terenceang/zx-sizif-512/images/revA.webp

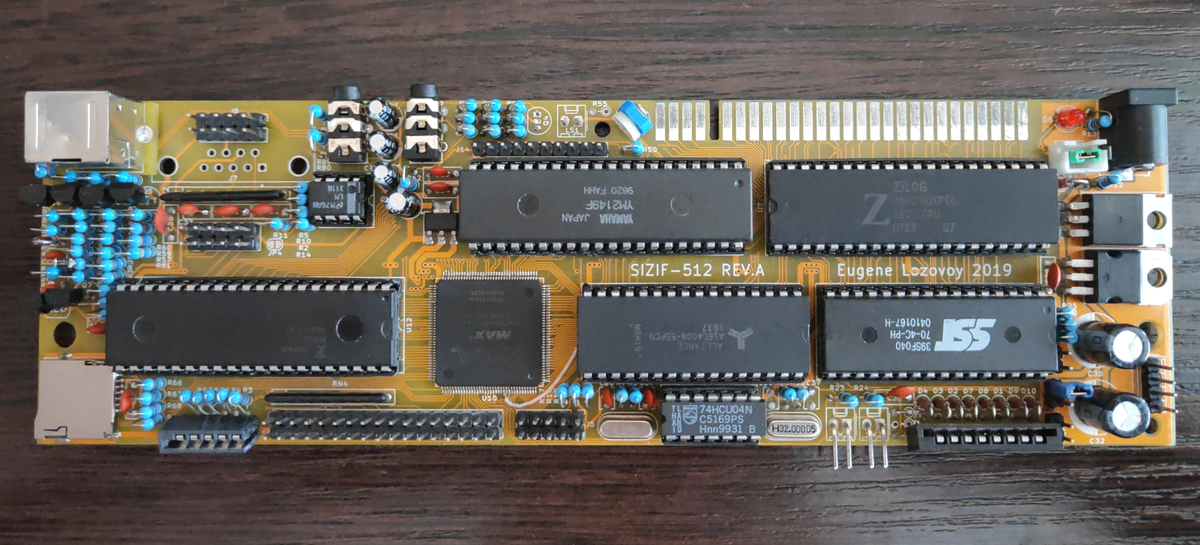
images/revA.webp
