terenceang/zx-sizif-512/images/revE.small.webp

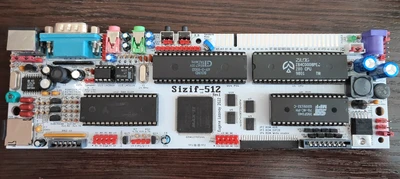
images/revE.small.webp
