terenceang/zx-sizif-512/out/pcb.rev.D1.pdf

# IO1_18/GCLK0 18 VCCINT 19

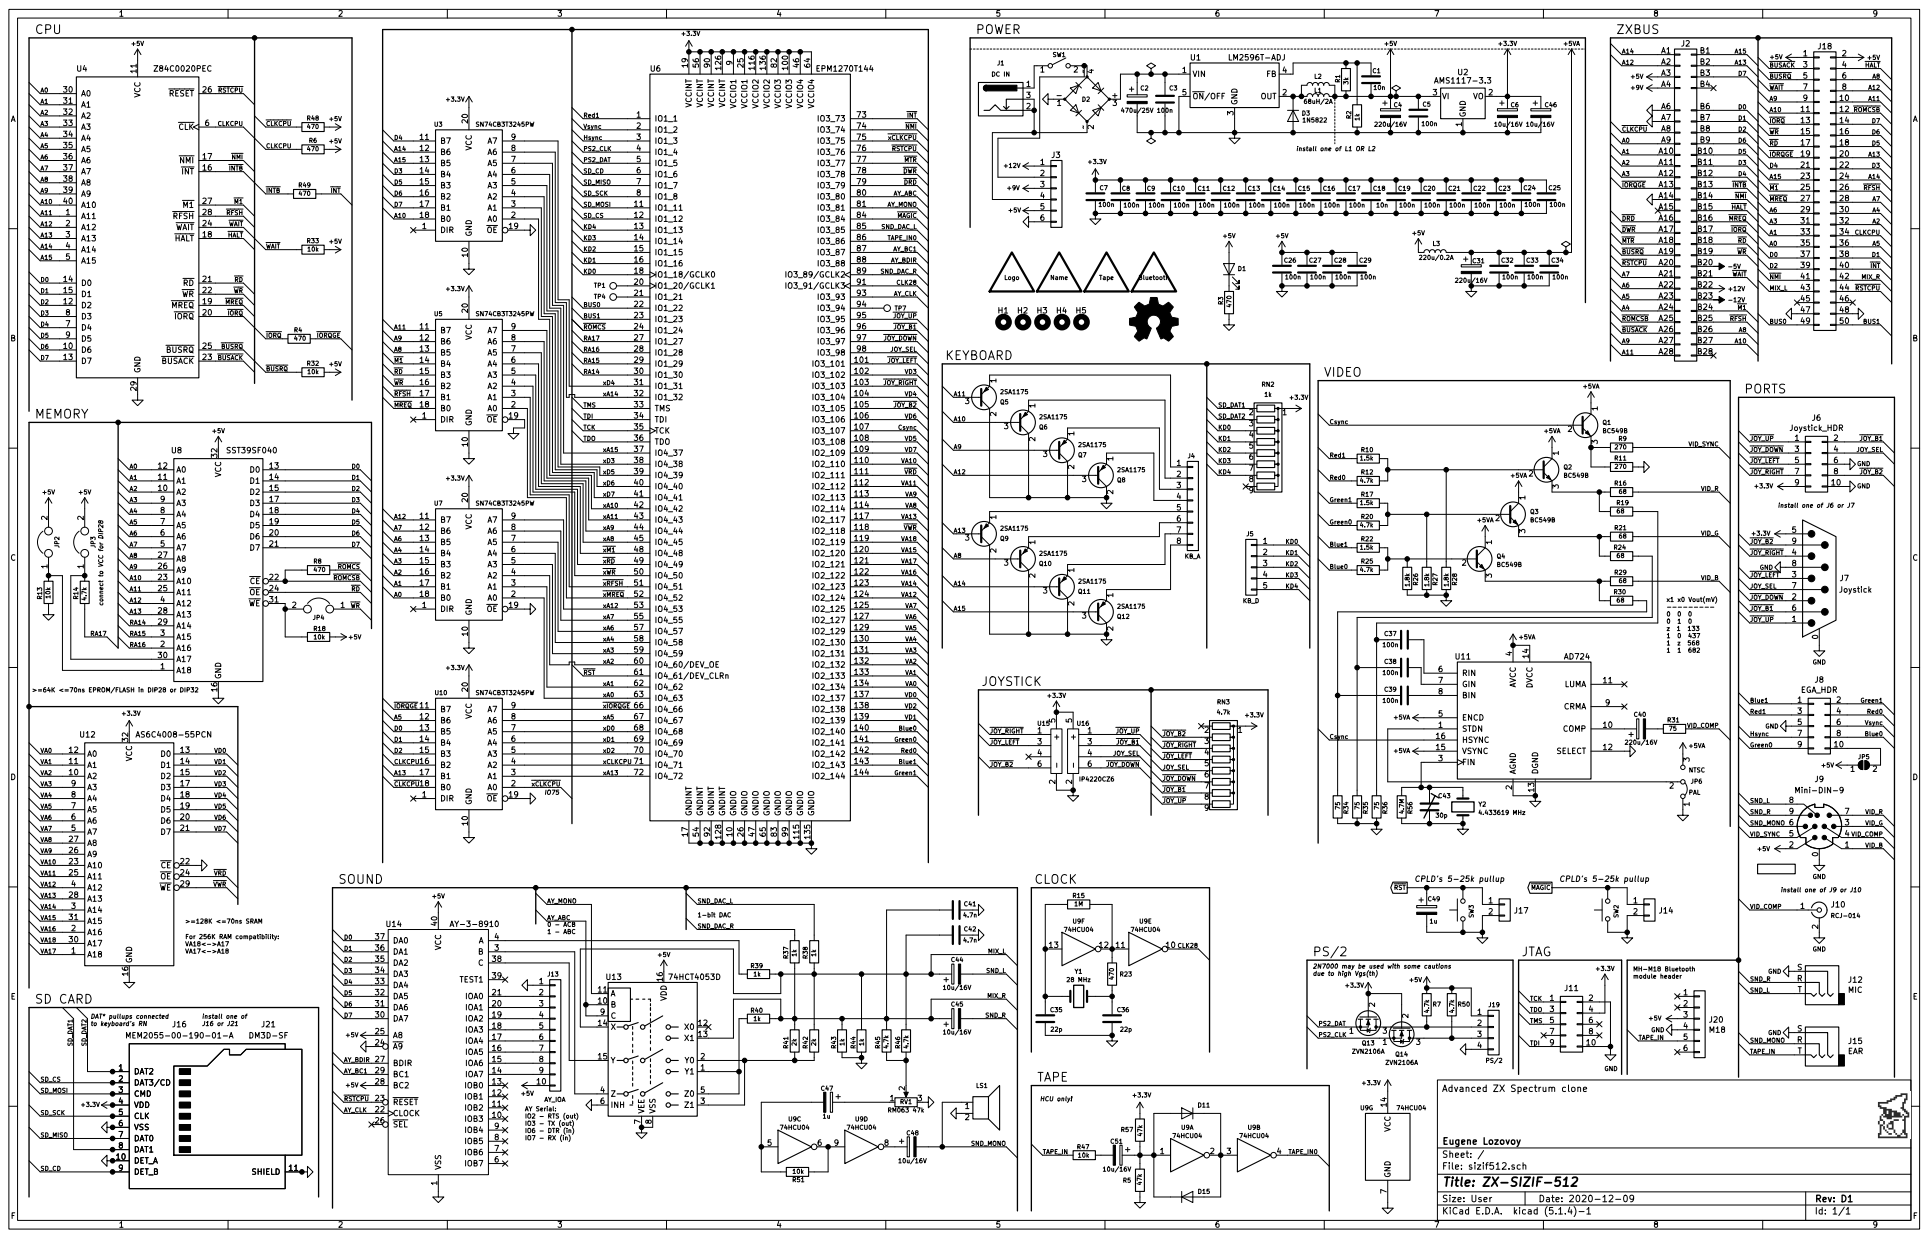
[picture p10: page 1]

install one of L1 OR L2

install one of J6 or J7

connect to VCC for DIP28

>=64K <=70ns EPROM/FLASH in DIP28 or DIP32

install one of J9 or J10

2N7000 may be used with some cautions
due to high Vgs(th)

Advanced ZX Spectrum clone

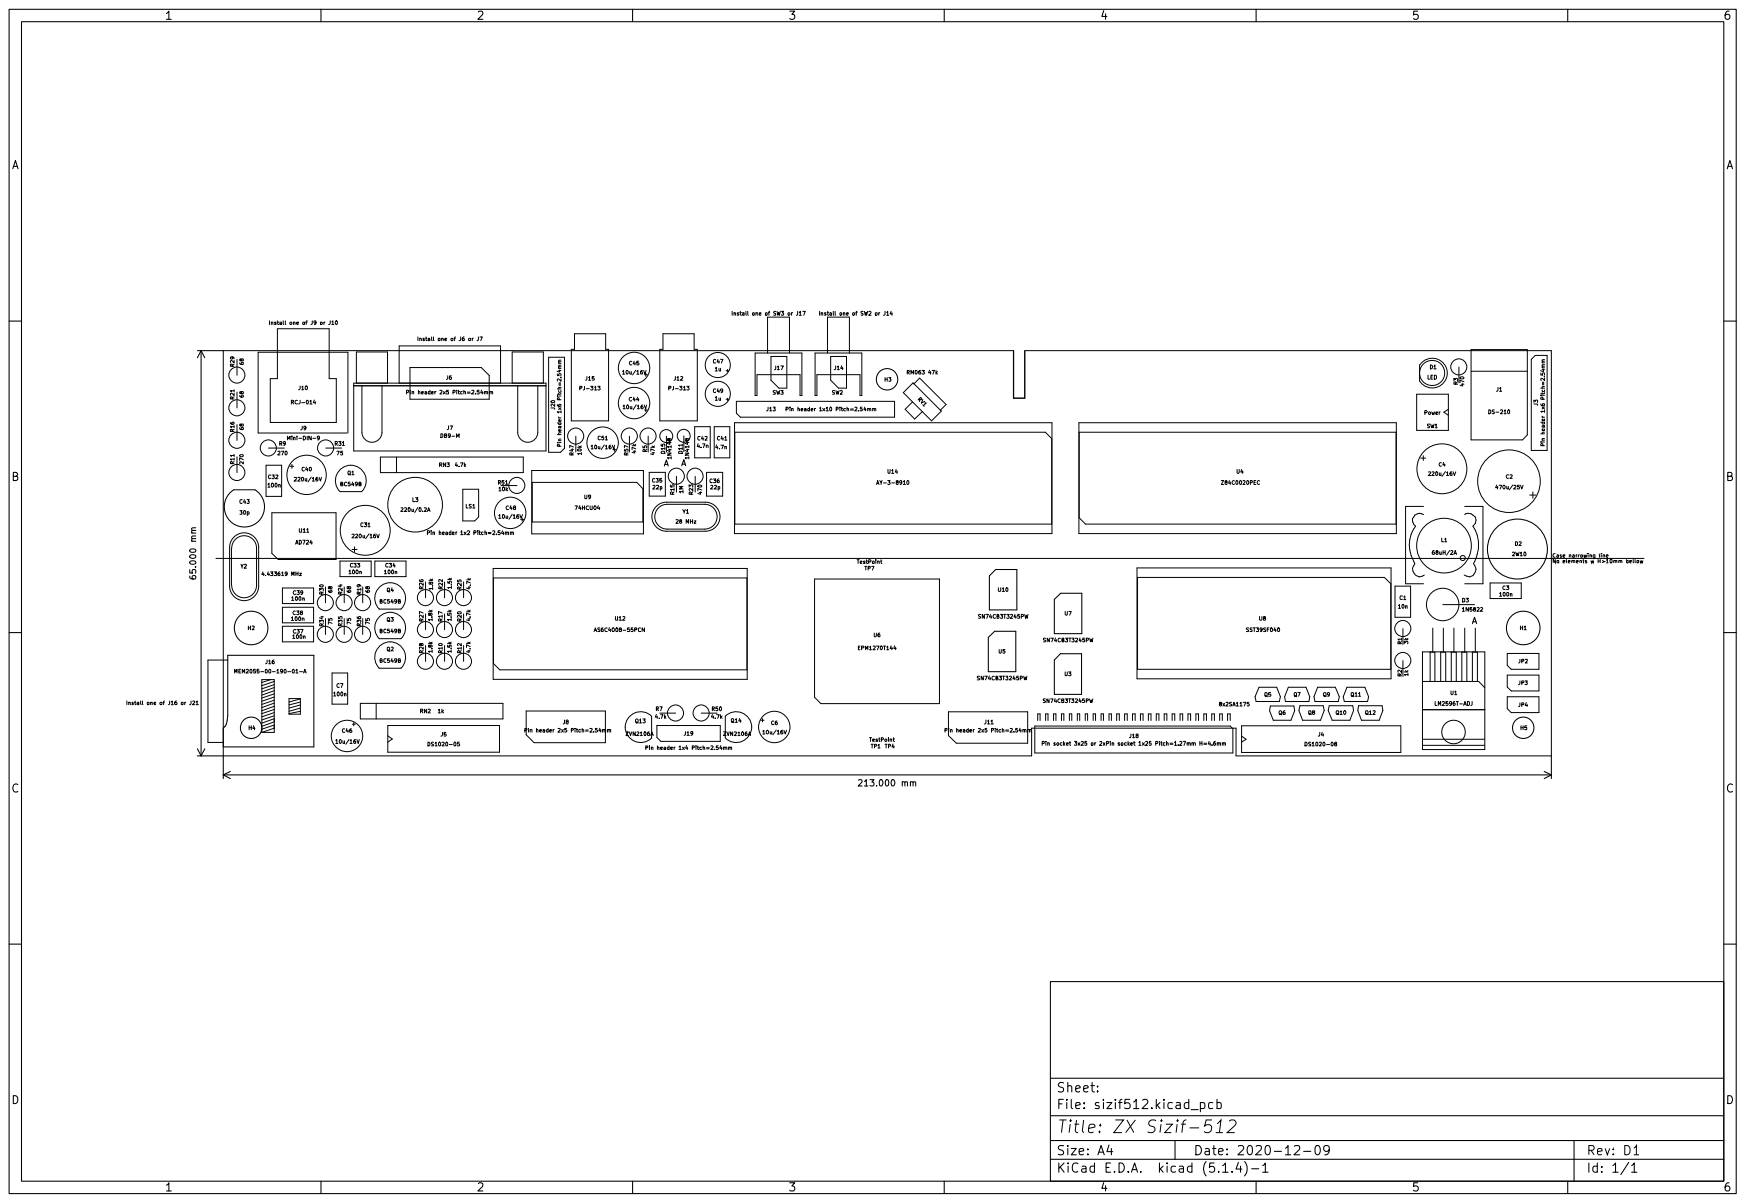
[picture p11: page 2]

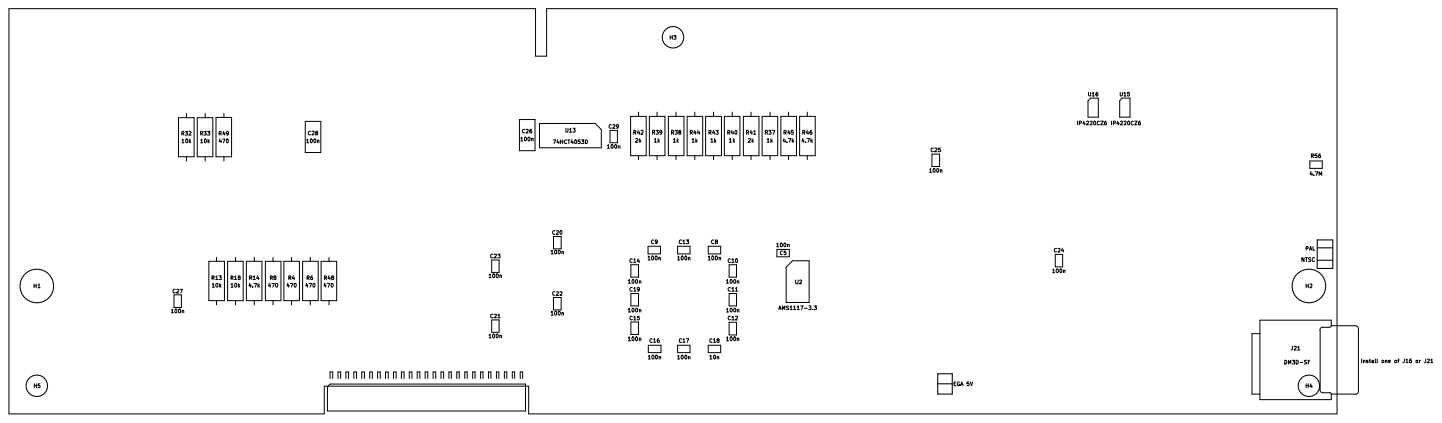
[picture p12: page 3]

Designator | Package | Designation | Quantity
C1 | C_Disc_D5.0mm_W2.5mm_P2.50mm | 10n | 1
C18 | C_0805_2012Metric_Pad1.15x1.40mm_HandSolder | 10n | 1
C2 | CP_Radial_D10.0mm_P5.00mm | 470u/25V | 1
C23,C27,C29,C25,C24,C22,C21,C20,C19,C17,C 16,C15,C14,C13,C12,C11,C10,C9,C8,C5 | C_0805_2012Metric_Pad1.15x1.40mm_HandSolder | 100n | 20
C26,C28,C7,C32,C3,C34,C33,C37,C38,C39 | C_Disc_D5.0mm_W2.5mm_P2.50mm | 100n | 10
C36,C35 | C_Disc_D3.8mm_W2.6mm_P2.50mm | 22p | 2
C4,C31 | CP_Radial_D8.0mm_P3.50mm | 220u/16V | 2
C40 | CP_Radial_D6.3mm_P2.50mm | 220u/16V | 1
C41,C42 | C_Disc_D5.0mm_W2.5mm_P2.50mm | 4.7n | 2
C43 | C_Trim_D6.3mm_P5.50mm | 30p | 1
C49,C47 | CP_Radial_D4.0mm_P2.00mm | 1u | 2
C6,C46,C44,C45,C51,C48 | CP_Radial_D5.0mm_P2.00mm | 10u/16V | 6
D1 | LED_D4.0mm | LED | 1
D15,D11 | D_DO-35_SOD27_P2.54mm_Vertical_AnodeUp | 1N4148 | 2
D2 | Diode_Bridge_Round_D10.0mm | 2W10 | 1
D3 | D_DO-201AD_P5.08mm_Vertical_AnodeUp | 1N5822 | 1
J1 | BarrelJack_Horizontal | DS-210 | 1
J10 | CUI_RCJ-01X-WIDE | RCJ-014 | 1
J12,J15 | PJ-313 | PJ-313 | 2
J13 | PinHeader_1x10_P2.54mm_Vertical | Pin header 1x10 Pitch=2.54mm | 1
J14,J17 | PinHeader_2x01_P2.54mm_Vertical | Pin header 1x2 Pitch=2.54mm | 2
J16 | GCT-MEM2055-00-190-01-A | MEM2055-00-190-01-A | 1
J18 | PinHeader_2x25_P1.27mm_Edge_SMD | Pin socket 3x25 or 2xPin socket 1x25 Pitch=1.27mm H=4.6mm | 1
J19 | PinHeader_1x04_P2.54mm_Vertical | Pin header 1x4 Pitch=2.54mm | 1
J20,J3 | PinHeader_1x06_P2.54mm_Vertical | Pin header 1x6 Pitch=2.54mm | 2
J21 | microSD_HC_Hirose_DM3D-SF | DM3D-SF | 1
J4 | FFC_FPC_1x08 | DS1020-08 | 1
J5 | FFC_FPC_1x05 | DS1020-05 | 1
J6,J8,J11 | PinHeader_2x05_P2.54mm_Vertical | Pin header 2x5 Pitch=2.54mm | 2
J7 | DSUB-9_Male_Horizontal_P2.77x2.84mm_EdgePinOffset4.94mm_Ho used_MountingHolesOffset7.48mm | DB9-M | 1
J9 | minidin-9 | Mini-DIN-9 | 1
JP3,JP4,JP2 | PinHeader_1x02_P2.54mm_Vertical | Jumper / Pin header 1x2 Pitch=2.54mm | 3
L1 | L_Radial_D8.7mm_P5.00mm_Fastron_07HCP | 68uH/2A | 1
L2 | L_12x12mm_H8mm | 68uH/2A | 1
L3 | L_Radial_D8.7mm_P5.00mm_Fastron_07HCP | 220u/0.2A | 1
LS1 | PinHeader_1x02_P2.54mm_Vertical | Pin header 1x2 Pitch=2.54mm | 1
Q10,Q8,Q12,Q11,Q9,Q7,Q6,Q5 | TO-92S | 2SA1175 | 8
Q13,Q14 | TO-92 | ZVN2106A | 2
Q4,Q3,Q2,Q1 | TO-92 | BC549B | 4
R1 | R_Axial_DIN0207_L6.3mm_D2.5mm_P2.54mm_Vertical | 3k | 1
R11,R9 | R_Axial_DIN0207_L6.3mm_D2.5mm_P2.54mm_Vertical | 270 | 2
R14,R46,R45 | R_Axial_DIN0207_L6.3mm_D2.5mm_P7.62mm_Horizontal | 4.7k | 3
R15 | R_Axial_DIN0207_L6.3mm_D2.5mm_P2.54mm_Vertical | 1M | 1
R2 | R_Axial_DIN0207_L6.3mm_D2.5mm_P2.54mm_Vertical | 1k | 1
R22,R17,R10 | R_Axial_DIN0207_L6.3mm_D2.5mm_P2.54mm_Vertical | 1.5k | 3
R23,R3 | R_Axial_DIN0207_L6.3mm_D2.5mm_P2.54mm_Vertical | 470 | 2
R28,R27,R26 | R_Axial_DIN0207_L6.3mm_D2.5mm_P2.54mm_Vertical | 1.8k | 3
R29,R16,R21,R30,R24,R19 | R_Axial_DIN0207_L6.3mm_D2.5mm_P2.54mm_Vertical | 68 | 6
R33,R32,R18,R13 | R_Axial_DIN0207_L6.3mm_D2.5mm_P7.62mm_Horizontal | 10k | 4
R34,R35,R36,R31 | R_Axial_DIN0207_L6.3mm_D2.5mm_P2.54mm_Vertical | 75 | 4
R42,R41 | R_Axial_DIN0207_L6.3mm_D2.5mm_P7.62mm_Horizontal | 2k | 2
R44,R43,R40,R39,R38,R37 | R_Axial_DIN0207_L6.3mm_D2.5mm_P7.62mm_Horizontal | 1k | 6
R47,R51 | R_Axial_DIN0207_L6.3mm_D2.5mm_P2.54mm_Vertical | 10k | 2
R5,R57 | R_Axial_DIN0207_L6.3mm_D2.5mm_P2.54mm_Vertical | 47k | 2
R50,R7,R25,R20,R12 | R_Axial_DIN0207_L6.3mm_D2.5mm_P2.54mm_Vertical | 4.7k | 5
R56 | R_0805_2012Metric_Pad1.15x1.40mm_HandSolder | 4.7M | 1

R8,R4,R49,R48,R6 | R_Axial_DIN0207_L6.3mm_D2.5mm_P7.62mm_Horizontal | 470 | 5
RN2 | R_Array_SIP9 | 1k | 1
RN3 | R_Array_SIP9 | 4.7k | 1
RV1 | Potentiometer_Runtron_RM-063_Horizontal | RM063 47k | 1
SW1 | Molex_KK-254_AE-6410-02A_1x02_P2.54mm_Vertical | Jumper / Pin header 1x2 Pitch=2.54mm | 1
SW2,SW3 | SW_Tactile_SPST_Angled_PTS645Vx83-2LFS | Button THT | 2
U1 | TO-220-263-5_Horizontal_TabDown | LM2596T-ADJ | 1
U11 | SOIC-16W_7.5x10.3mm_P1.27mm | AD724 | 1
U12 | DIP-32_W15.24mm_Socket | AS6C4008-55PCN | 1
U13 | SOIC-16_3.9x9.9mm_P1.27mm | 74HCT4053D | 1
U14 | DIP-40_W15.24mm_Socket | AY-3-8910 | 1
U16,U15 | TSOP-6_1.65x3.05mm_P0.95mm | IP4220CZ6 | 2
U2 | SOT-223-3_TabPin2 | AMS1117-3.3 | 1
U4 | DIP-40_W15.24mm_Socket | Z84C0020PEC | 1
U5,U3,U10,U7 | TSSOP-20_4.4x6.5mm_P0.65mm | SN74CB3T3245PW | 4
U6 | LQFP-144_20x20mm_P0.5mm | EPM1270T144 | 1
U8 | DIP-32_W15.24mm_Socket | SST39SF040 | 1
U9 | DIP-14_W7.62mm_Socket | 74HCU04 | 1
Y1 | Crystal_HC49-U_Vertical | 28 MHz | 1
Y2 | Crystal_HC49-U_Vertical | 4.433619 MHz | 1
