terenceang/zx-sizif-512/pcb/rev.E1/sizif512.kicad_sch

## KiCad design pcb/rev.E1/sizif512.kicad_sch (2023-01-15)

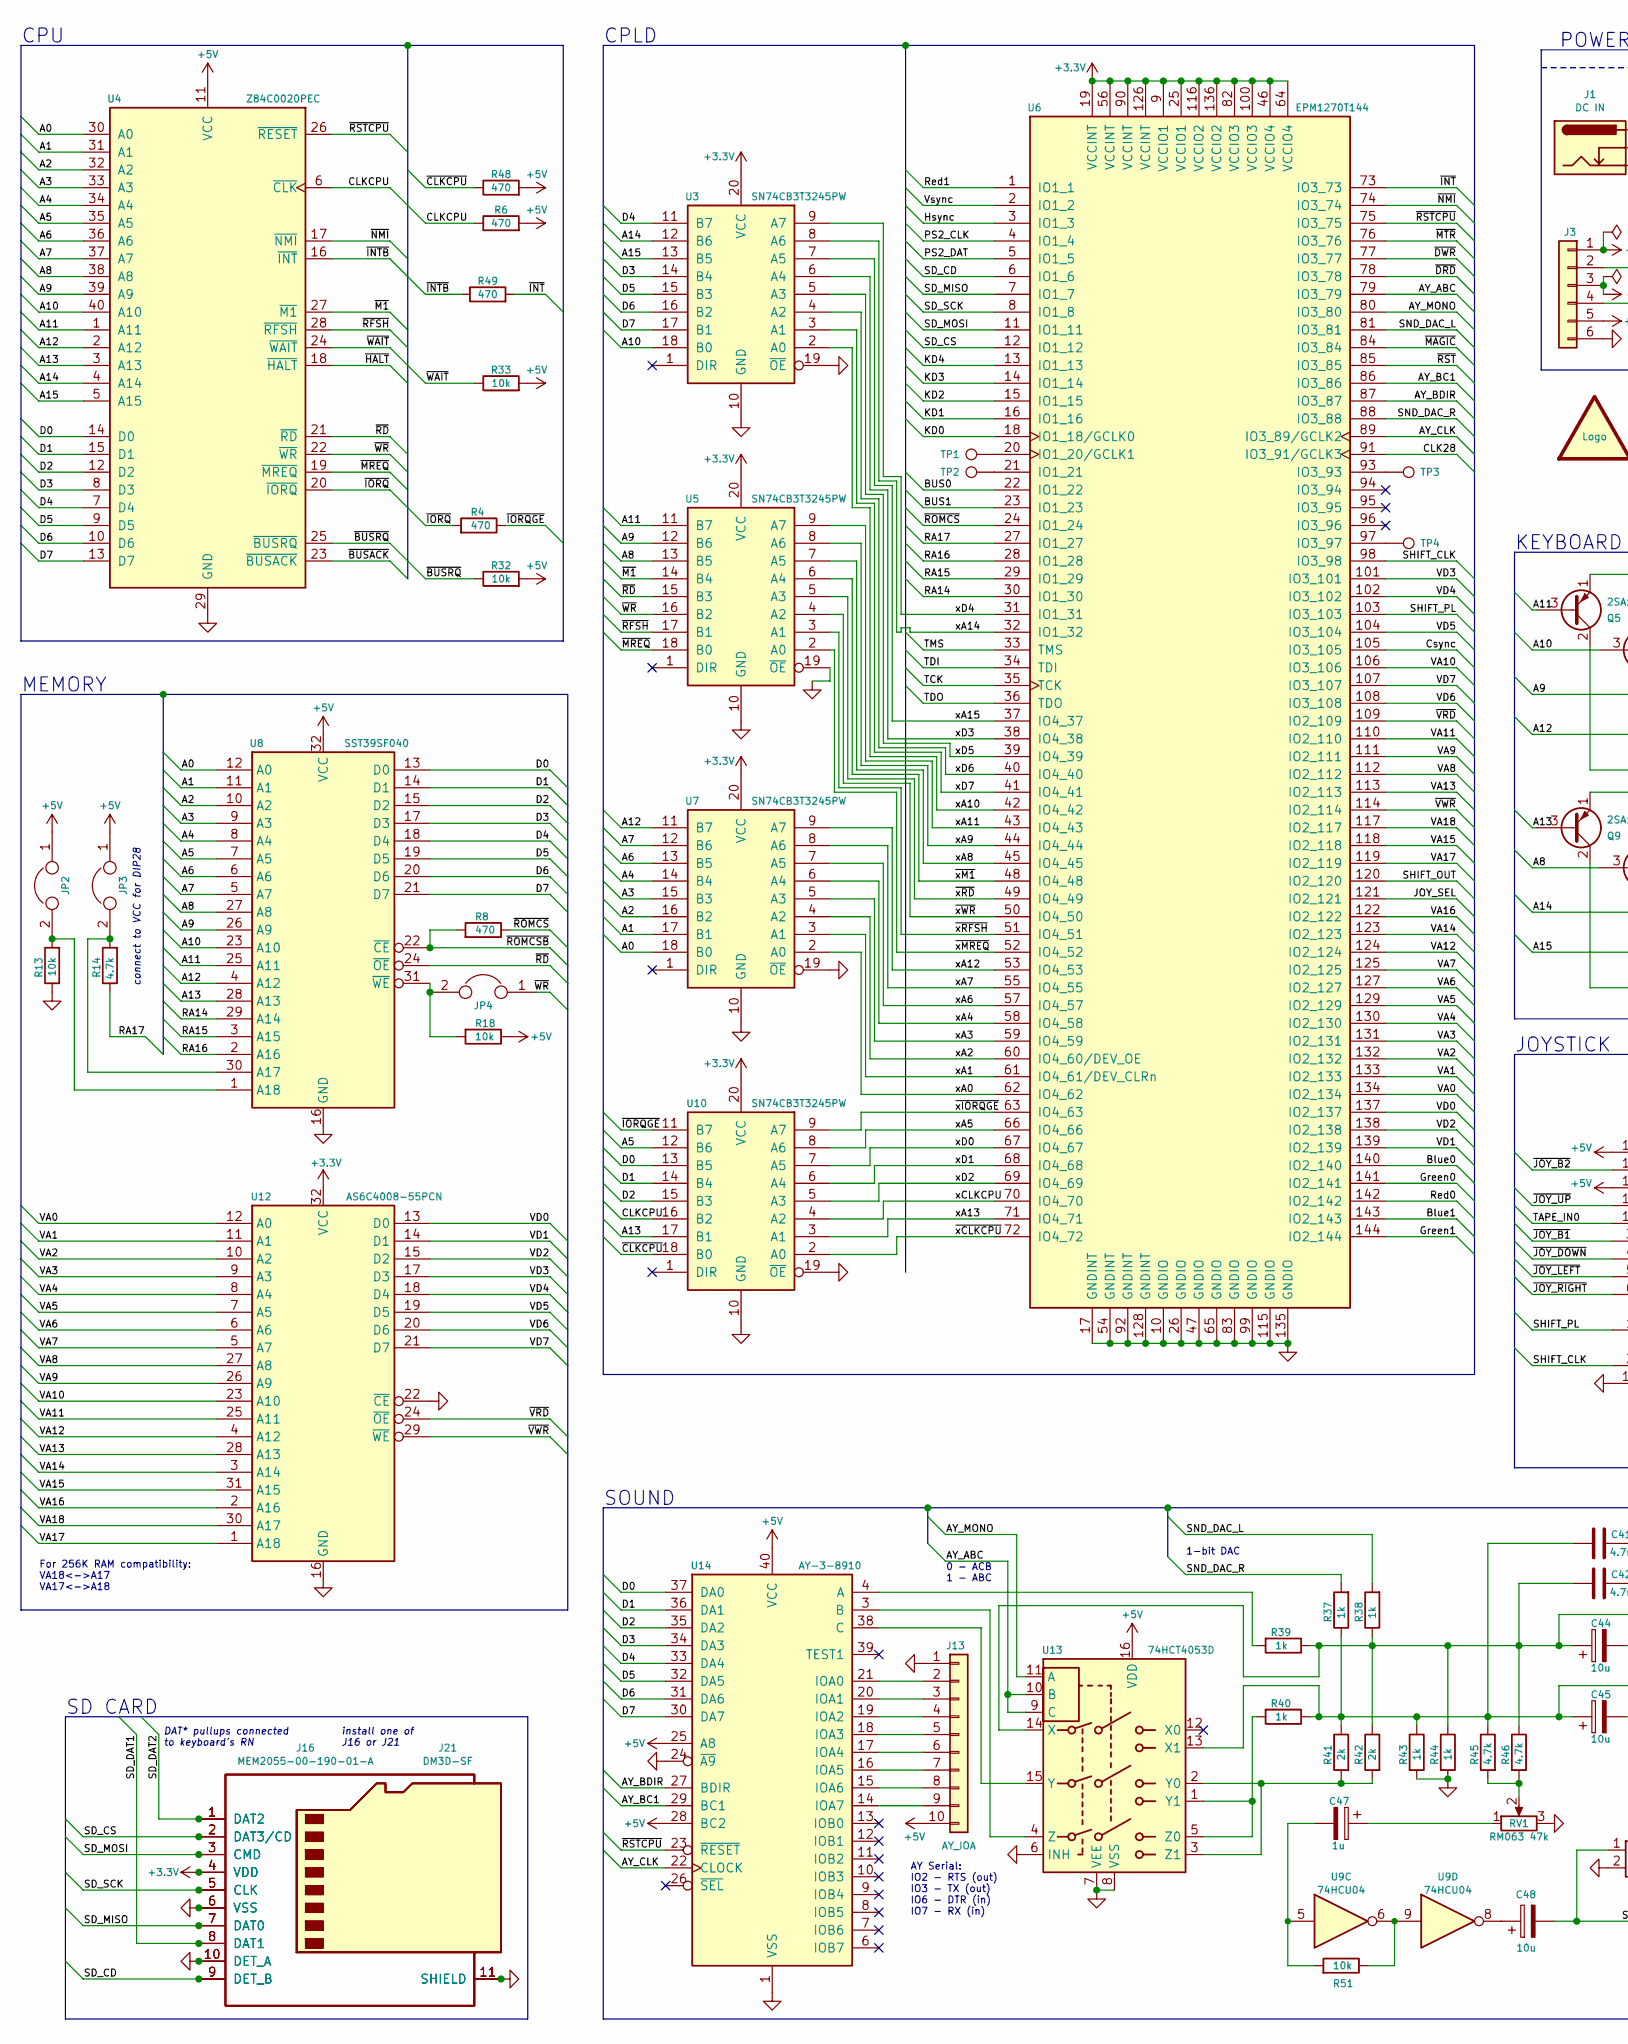
[picture p16: schematic sizif512.kicad_sch, part in row 1, column 1]

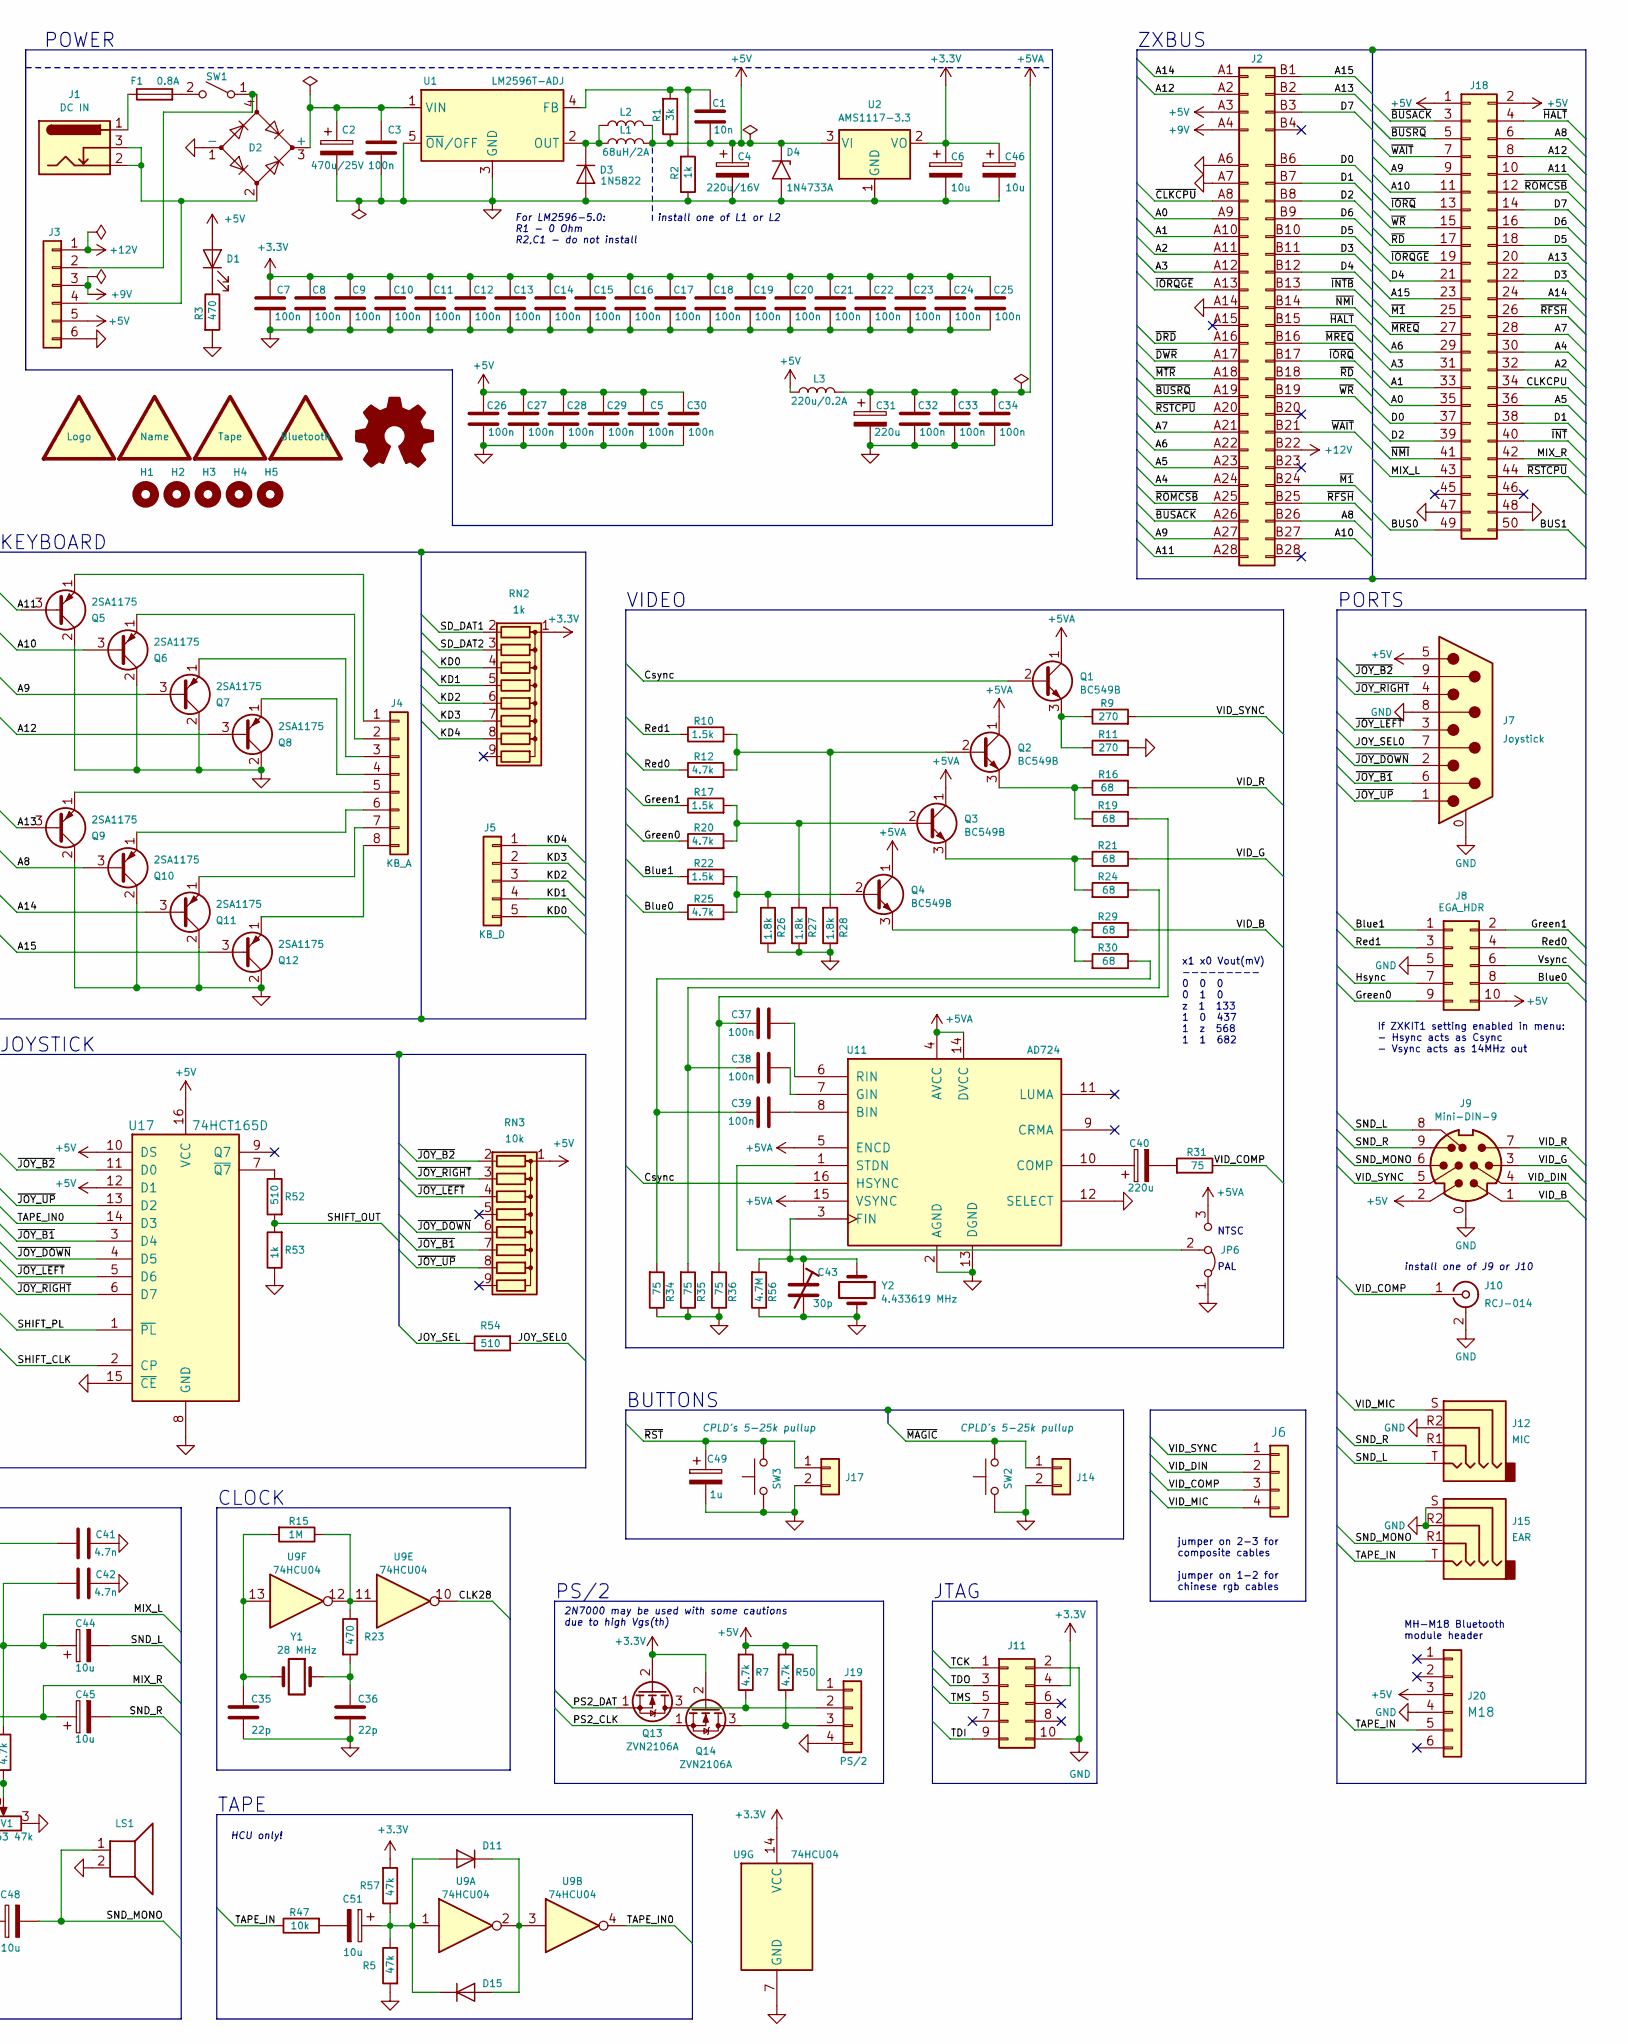
[picture p17: schematic sizif512.kicad_sch, part in row 1, column 2]

Parts:
C1: 10n; C_Disc_D5.0mm_W2.5mm_P2.50mm
C2: 470u/25V; CP_Radial_D10.0mm_P5.00mm
C3, C7, C26, C28, C32, C33, C34: 100n; C_Disc_D5.0mm_W2.5mm_P2.50mm
C4: 220u/16V; CP_Radial_D8.0mm_P3.50mm
C5, C8, C9, C10, C11, C12, C13, C14, C15, C16, C17, C18, C19, C20, C21, C22, C23, C24, C27, C29: 100n; C_0805_2012Metric_Pad1.15x1.40mm_HandSolder
C6, C44, C45, C46, C48, C51: 10u; CP_Radial_D5.0mm_P2.00mm
C25, C30: 100n; C_0805_2012Metric_Pad1.18x1.45mm_HandSolder
C31, C40: 220u; CP_Radial_D6.3mm_P2.50mm
C35, C36: 22p; C_Disc_D3.8mm_W2.6mm_P2.50mm
C37, C38, C39: 100n; C_Rect_L7.0mm_W3.5mm_P2.50mm_P5.00mm
C41, C42: 4.7n; C_Disc_D5.0mm_W2.5mm_P2.50mm
C43: 30p; C_Trim_D6.3mm_P5.50mm
C47, C49: 1u; CP_Radial_D4.0mm_P2.00mm
D1: LED; LED_D4.0mm
D2: 2W10; Diode_Bridge_Round_D10.0mm
D3: 1N5822; D_DO-201AD_P5.08mm_Vertical_AnodeUp
D4: 1N4733A; D_DO-15_P3.81mm_Vertical_KathodeUp
D11, D15: 1N4148; D_DO-35_SOD27_P2.54mm_Vertical_AnodeUp
F1: 0.8A; Fuse_1812_4532Metric_Pad1.30x3.40mm_HandSolder
H1, H2: MountingHole; MountingHole_5mm_7mm_fence
H3, H4, H5: MountingHole; MountingHole_3mm
J1: DS-210; BarrelJack_Horizontal
J2: Conn_02x28_Row_Letter_First; ZX_EDGE
J3, J20: Pin header 1x6 Pitch=2.54mm; PinHeader_1x06_P2.54mm_Vertical
J4: DS1020-08; FFC_FPC_1x08
J5: DS1020-05; FFC_FPC_1x05
J6, J19: Pin header 1x4 Pitch=2.54mm; PinHeader_1x04_P2.54mm_Vertical
J7: DB9-M; DSUB-9_Male_Horizontal_P2.77x2.84mm_EdgePinOffset4.94mm_Hou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
J8, J11: Pin header 2x5 Pitch=2.54mm; PinHeader_2x05_P2.54mm_Vertical
J9: Mini-DIN-9; minidin-9
J10: RCJ-014; CUI_RCJ-01X-WIDE
J12, J15: PJ-322
J13: Pin header 1x10 Pitch=2.54mm; PinHeader_1x10_P2.54mm_Vertical
J14, J17: Pin header 1x2 Pitch=2.54mm; PinHeader_2x01_P2.54mm_Vertical
J16: MEM2055-00-190-01-A; GCT-MEM2055-00-190-01-A
J18: Pin socket 3x25 or 2xPin socket 1x25 Pitch=1.27mm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; PinHeader_2x25_P1.27mm_Edge_SMD
J21: DM3D-SF; microSD_HC_Hirose_DM3D-SF
JP2, JP3, JP4: Jumper / Pin header 1x2 Pitch=2.54mm; PinHeader_1x02_P2.54mm_Vertical
JP6: Jumper_3_Bridged12; SolderJumper-3_P1.3mm_Bridged12_RoundedPad1.0x1.5mm_NumberL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
L1: 68uH/2A; L_Radial_D8.7mm_P5.00mm_Fastron_07HCP
L2: 68uH/2A; L_12x12mm_H8mm
L3: 220u/0.2A; L_Radial_D8.7mm_P5.00mm_Fastron_07HCP
LOGO1: graphic; black-mage-12.5x8.6-r
LOGO2: Logo_Open_Hardware_Small; OSHW-Symbol_6.7x6mm_SilkScreen
LOGO3: graphic; jack35
LOGO4: graphic; bluetooth_small
LOGO5: graphic; sizif512
LS1: Pin header 1x2 Pitch=2.54mm; PinHeader_1x02_P2.54mm_Vertical
Q1, Q2, Q3, Q4: BC549B; TO-92
Q5, Q6, Q7, Q8, Q9, Q10, Q11, Q12: 2SA1175; TO-92S
Q13, Q14: ZVN2106A; TO-92
R1: 3k; R_Axial_DIN0207_L6.3mm_D2.5mm_P2.54mm_Vertical
R2: 1k; R_Axial_DIN0207_L6.3mm_D2.5mm_P2.54mm_Vertical
R3, R23: 470; R_Axial_DIN0207_L6.3mm_D2.5mm_P2.54mm_Vertical
R4, R6, R8, R48, R49: 470; R_Axial_DIN0207_L6.3mm_D2.5mm_P7.62mm_Horizontal
R5, R57: 47k; R_Axial_DIN0207_L6.3mm_D2.5mm_P2.54mm_Vertical
R7, R12, R20, R25, R50: 4.7k; R_Axial_DIN0207_L6.3mm_D2.5mm_P2.54mm_Vertical
R9, R11: 270; R_Axial_DIN0207_L6.3mm_D2.5mm_P2.54mm_Vertical
R10, R17, R22: 1.5k; R_Axial_DIN0207_L6.3mm_D2.5mm_P2.54mm_Vertical
R13, R18, R32, R33: 10k; R_Axial_DIN0207_L6.3mm_D2.5mm_P7.62mm_Horizontal
R14, R45, R46: 4.7k; R_Axial_DIN0207_L6.3mm_D2.5mm_P7.62mm_Horizontal
R15: 1M; R_Axial_DIN0207_L6.3mm_D2.5mm_P2.54mm_Vertical
R16, R19, R21, R24, R29, R30: 68; R_Axial_DIN0207_L6.3mm_D2.5mm_P2.54mm_Vertical
R26, R27, R28: 1.8k; R_Axial_DIN0207_L6.3mm_D2.5mm_P2.54mm_Vertical
R31, R34, R35, R36: 75; R_Axial_DIN0207_L6.3mm_D2.5mm_P2.54mm_Vertical
R37, R38, R39, R40, R43, R44, R53: 1k; R_Axial_DIN0207_L6.3mm_D2.5mm_P7.62mm_Horizontal
R41, R42: 2k; R_Axial_DIN0207_L6.3mm_D2.5mm_P7.62mm_Horizontal
R47, R51: 10k; R_Axial_DIN0207_L6.3mm_D2.5mm_P2.54mm_Vertical
R52, R54: 510; R_Axial_DIN0207_L6.3mm_D2.5mm_P7.62mm_Horizontal
R56: 4.7M; R_0805_2012Metric_Pad1.15x1.40mm_HandSolder
RN2: 1k; R_Array_SIP9
RN3: 10k; R_Array_SIP9
RV1: RM063 47k; Potentiometer_Runtron_RM-063_Horizontal
SW1: Jumper / Pin header 1x2 Pitch=2.54mm; Molex_KK-254_AE-6410-02A_1x02_P2.54mm_Vertical
SW2, SW3: Button THT; SW_Tactile_SPST_Angled_PTS645Vx83-2LFS
TP1, TP2, TP3, TP4: TestPoint; TestPoint_Pad_D1.0mm
U1: LM2596T-ADJ; TO-220-263-5_Horizontal_TabDown
U2: AMS1117-3.3; SOT-223-3_TabPin2
U3, U5, U7, U10: SN74CB3T3245PW; TSSOP-20_4.4x6.5mm_P0.65mm
U4: Z84C0020PEC; DIP-40_W15.24mm_Socket
U6: EPM1270T144; LQFP-144_20x20mm_P0.5mm
U8: SST39SF040; DIP-32_W15.24mm_Socket
U9: 74HCU04; DIP-14_W7.62mm_Socket
U11: AD724; SOIC-16W_7.5x10.3mm_P1.27mm
U12: AS6C4008-55PCN; DIP-32_W15.24mm_Socket
U13: 74HCT4053D; SOIC-16_3.9x9.9mm_P1.27mm
U14: AY-3-8910; DIP-40_W15.24mm_Socket
U17: 74HCT165D; SOIC-16_3.9x9.9mm_P1.27mm
Y1: 28 MHz; Crystal_HC49-U_Vertical
Y2: 4.433619 MHz; Crystal_HC49-U_Vertical

Connections:
+3.3V: C6.1, C7.2, C8.1, C9.1, C10.1, C11.1, C12.1, C13.1, C14.1, C15.1, C16.1, C17.1, C18.1, C19.1, C20.1, C21.1, C22.1, C23.1, C24.2, C25.2, C46.1, J11.4, J16.4 (VDD), J21.4 (VDD), Q13.2 (G), Q14.2 (G), R57.2, RN2.1 (common), U2.2 (VO), U3.20 (VCC), U5.20 (VCC), U6.9 (VCCIO1), U6.19 (VCCINT), U6.25 (VCCIO1), U6.46 (VCCIO4), U6.56 (VCCINT), U6.64 (VCCIO4), U6.82 (VCCIO3), U6.90 (VCCINT), U6.100 (VCCIO3), U6.116 (VCCIO2), U6.126 (VCCINT), U6.136 (VCCIO2), U7.20 (VCC), U9.14 (VCC), U10.20 (VCC), U12.32 (VCC)
+5V: C1.1, C4.1, C5.2, C26.2, C27.2, C28.2, C29.2, C30.2, D1.2 (A), D4.1 (A1), J2.A3 (Pin_a3), J3.5, J7.5, J8.10, J9.2, J13.10, J18.1, J18.2, J19.1, J20.3, JP2.1, JP3.1, L1.2, L2.2, L3.1, R1.1, R6.2, R7.2, R18.1, R32.2, R33.2, R48.2, R50.2, RN3.1 (common), U2.3 (VI), U4.11 (VCC), U8.32 (VCC), U13.16 (VDD), U14.25 (A8), U14.28 (BC2), U14.40 (VCC), U17.10 (DS), U17.12 (D1), U17.16 (VCC)
+5VA: C31.1, C32.2, C33.2, C34.2, JP6.3 (B), L3.2, Q1.1 (C), Q2.1 (C), Q3.1 (C), Q4.1 (C), U11.4 (AVCC), U11.5 (ENCD), U11.14 (DVCC), U11.15 (VSYNC)
+9V: J2.A4 (Pin_a4), J3.3
+12V: J2.B22 (Pin_b22), J3.1
A0: J2.A9 (Pin_a9), J18.35, U4.30 (A0), U7.18 (B0), U8.12 (A0)
A1: J2.A10 (Pin_a10), J18.33, U4.31 (A1), U7.17 (B1), U8.11 (A1)
A2: J2.A11 (Pin_a11), J18.32, U4.32 (A2), U7.16 (B2), U8.10 (A2)
A3: J2.A12 (Pin_a12), J18.31, U4.33 (A3), U7.15 (B3), U8.9 (A3)
A4: J2.A24 (Pin_a24), J18.30, U4.34 (A4), U7.14 (B4), U8.8 (A4)
A5: J2.A23 (Pin_a23), J18.36, U4.35 (A5), U8.7 (A5), U10.12 (B6)
A6: J2.A22 (Pin_a22), J18.29, U4.36 (A6), U7.13 (B5), U8.6 (A6)
A7: J2.A21 (Pin_a21), J18.28, U4.37 (A7), U7.12 (B6), U8.5 (A7)
A8: J2.B26 (Pin_b26), J18.6, Q10.3 (B), U4.38 (A8), U5.13 (B5), U8.27 (A8)
A9: J2.A27 (Pin_a27), J18.9, Q7.3 (B), U4.39 (A9), U5.12 (B6), U8.26 (A9)
A10: J2.B27 (Pin_b27), J18.11, Q6.3 (B), U3.18 (B0), U4.40 (A10), U8.23 (A10)
A11: J2.A28 (Pin_a28), J18.10, Q5.3 (B), U4.1 (A11), U5.11 (B7), U8.25 (A11)
A12: J2.A2 (Pin_a2), J18.8, Q8.3 (B), U4.2 (A12), U7.11 (B7), U8.4 (A12)
A13: J2.B2 (Pin_b2), J18.20, Q9.3 (B), U4.3 (A13), U8.28 (A13), U10.17 (B1)
A14: J2.A1 (Pin_a1), J18.24, Q11.3 (B), U3.12 (B6), U4.4 (A14)
A15: J2.B1 (Pin_b1), J18.23, Q12.3 (B), U3.13 (B5), U4.5 (A15)
AY_ABC: U6.79 (IO3_79), U13.9 (C), U13.10 (B)
AY_BC1: U6.86 (IO3_86), U14.29 (BC1)
AY_BDIR: U6.87 (IO3_87), U14.27 (BDIR)
AY_CLK: U6.89 (IO3_89/GCLK2), U14.22 (CLOCK)
AY_MONO: U6.80 (IO3_80), U13.11 (A)
BUS0: J18.49, U6.22 (IO1_22)
BUS1: J18.50, U6.23 (IO1_23)
Blue0: J8.8, R25.1, U6.140 (IO2_140)
Blue1: J8.1, R22.1, U6.143 (IO2_143)
CLK28: U6.91 (IO3_91/GCLK3), U9.10
CLKCPU: J18.34, R6.1, U4.6 (~CLK), U10.16 (B2)
Csync: Q1.2 (B), U6.105 (IO3_105), U11.16 (HSYNC)
D0: J2.B6 (Pin_b6), J18.37, U4.14 (D0), U8.13 (D0), U10.13 (B5), U14.37 (DA0)
D1: J2.B7 (Pin_b7), J18.38, U4.15 (D1), U8.14 (D1), U10.14 (B4), U14.36 (DA1)
D2: J2.B8 (Pin_b8), J18.39, U4.12 (D2), U8.15 (D2), U10.15 (B3), U14.35 (DA2)
D3: J2.B11 (Pin_b11), J18.22, U3.14 (B4), U4.8 (D3), U8.17 (D3), U14.34 (DA3)
D4: J2.B12 (Pin_b12), J18.21, U3.11 (B7), U4.7 (D4), U8.18 (D4), U14.33 (DA4)
D5: J2.B10 (Pin_b10), J18.18, U3.15 (B3), U4.9 (D5), U8.19 (D5), U14.32 (DA5)
D6: J2.B9 (Pin_b9), J18.16, U3.16 (B2), U4.10 (D6), U8.20 (D6), U14.31 (DA6)
D7: J2.B3 (Pin_b3), J18.14, U3.17 (B1), U4.13 (D7), U8.21 (D7), U14.30 (DA7)
GND: C2.2, C3.2, C4.2, C5.1, C6.2, C7.1, C8.2, C9.2, C10.2, C11.2, C12.2, C13.2, C14.2, C15.2, C16.2, C17.2, C18.2, C19.2, C20.2, C21.2, C22.2, C23.2, C24.1, C25.1, C26.1, C27.1, C28.1, C29.1, C30.1, C31.2, C32.1, C33.1, C34.1, C35.1, C36.1, C41.1, C42.1, C43.2, C46.2, C49.2, D2.1 (-), D3.2 (A), D4.2 (A2), J2.A6 (Pin_a6), J2.A7 (Pin_a7), J2.A14 (Pin_a14), J3.6, J7.0 (PAD), J7.8, J8.5, J9.0, J10.2 (Ext), J11.2, J11.10, J12.R2, J13.1, J14.2, J15.R2, J15.S, J16.6 (VSS), J16.10 (DET_A), J16.11 (SHIELD), J17.2, J18.47, J18.48, J19.4, J20.4, J21.6 (VSS), J21.10 (DET_A), J21.11 (SHIELD), JP6.1 (A), LS1.2, Q5.2 (C), Q6.2 (C), Q7.2 (C), Q8.2 (C), Q9.2 (C), Q10.2 (C), Q11.2 (C), Q12.2 (C), R2.1, R3.2, R5.2, R11.2, R13.1, R26.1, R27.1, R28.1, R34.1, R35.1, R36.1, R43.2, R44.2, R53.1, R56.1, RV1.3, SW2.1, SW3.1, U1.3 (GND), U1.5 (~ON/OFF), U2.1 (GND), U3.10 (GND), U3.19 (~OE), U4.29 (GND), U5.10 (GND), U5.19 (~OE), U6.10 (GNDIO), U6.17 (GNDINT), U6.26 (GNDIO), U6.47 (GNDIO), U6.54 (GNDINT), U6.65 (GNDIO), U6.83 (GNDIO), U6.92 (GNDINT), U6.99 (GNDIO), U6.115 (GNDIO), U6.128 (GNDINT), U6.135 (GNDIO), U7.10 (GND), U7.19 (~OE), U8.16 (GND), U9.7 (GND), U10.10 (GND), U10.19 (~OE), U11.2 (AGND), U11.12 (SELECT), U11.13 (DGND), U12.16 (GND), U12.22 (~CE), U13.6 (INH), U13.7 (VEE), U13.8 (VSS), U14.1 (VSS), U14.24 (~A9), U17.8 (GND), U17.15 (~CE), Y2.2
Green0: J8.9, R20.1, U6.141 (IO2_141)
Green1: J8.2, R17.1, U6.144 (IO2_144)
Hsync: J8.7, U6.3 (IO1_3)
JOY_SEL: R54.1, U6.121 (IO2_121)
JOY_SEL0: J7.7, R54.2
KD0: J5.5, RN2.4 (R3), U6.18 (IO1_18/GCLK0)
KD1: J5.4, RN2.5 (R4), U6.16 (IO1_16)
KD2: J5.3, RN2.6 (R5), U6.15 (IO1_15)
KD3: J5.2, RN2.7 (R6), U6.14 (IO1_14)
KD4: J5.1, RN2.8 (R7), U6.13 (IO1_13)
MIX_L: C42.2, C44.1, J18.43, R38.1, R39.1, R42.1, R44.1, R46.1, U13.14 (X)
MIX_R: C41.2, C45.1, J18.42, R37.1, R40.1, R41.1, R43.1, R45.1, U13.13 (X1)
unnamed: C1.2, R1.2, R2.2, U1.4 (FB)
unnamed: C2.1, C3.1, D2.3 (+), U1.1 (VIN)
unnamed: C35.2, R15.2, U9.13, Y1.2
unnamed: C36.2, R23.2, Y1.1
unnamed: C37.1, R19.1, R36.2
unnamed: C37.2, U11.6 (RIN)
unnamed: C38.1, R24.1, R35.2
unnamed: C38.2, U11.7 (GIN)
unnamed: C39.1, R30.1, R34.2
unnamed: C39.2, U11.8 (BIN)
unnamed: C40.1, U11.10 (COMP)
unnamed: C40.2, R31.2
unnamed: C43.1, R56.2, U11.3 (FIN), Y2.1
unnamed: C47.1, RV1.1
unnamed: C47.2, R51.2, U9.5
unnamed: C48.1, U9.8
unnamed: C51.1, D11.2 (A), D15.1 (K), R5.1, R57.1, U9.1
unnamed: C51.2, R47.2
unnamed: D1.1 (K), R3.1
unnamed: D2.2, J1.2, J1.3, J3.4
unnamed: D2.4, J3.2, SW1.1 (A)
unnamed: D3.1 (K), L1.1, L2.1, U1.2 (OUT)
unnamed: D11.1 (K), D15.2 (A), U9.2, U9.3
unnamed: F1.1, J1.1
unnamed: F1.2, SW1.2 (B)
unnamed: J4.1, Q5.1 (E)
unnamed: J4.2, Q6.1 (E)
unnamed: J4.3, Q7.1 (E)
unnamed: J4.4, Q8.1 (E)
unnamed: J4.5, Q9.1 (E)
unnamed: J4.6, Q10.1 (E)
unnamed: J4.7, Q11.1 (E)
unnamed: J4.8, Q12.1 (E)
unnamed: J13.2, U14.21 (IOA0)
unnamed: J13.3, U14.20 (IOA1)
unnamed: J13.4, U14.19 (IOA2)
unnamed: J13.5, U14.18 (IOA3)
unnamed: J13.6, U14.17 (IOA4)
unnamed: J13.7, U14.16 (IOA5)
unnamed: J13.8, U14.15 (IOA6)
unnamed: J13.9, U14.14 (IOA7)
unnamed: J19.2, Q13.3 (D), R7.1
unnamed: J19.3, Q14.3 (D), R50.1
unnamed: JP2.2, R13.2, U8.1 (A18)
unnamed: JP3.2, R14.2, U8.30 (A17)
unnamed: JP4.2, R18.2, U8.31 (~WE)
unnamed: JP6.2 (C), U11.1 (STDN)
unnamed: Q1.3 (E), R9.1, R11.1
unnamed: Q2.2 (B), R10.2, R12.2, R28.2
unnamed: Q2.3 (E), R16.1, R19.2
unnamed: Q3.2 (B), R17.2, R20.2, R27.2
unnamed: Q3.3 (E), R21.2, R24.2
unnamed: Q4.2 (B), R22.2, R25.2, R26.2
unnamed: Q4.3 (E), R29.2, R30.2
unnamed: R15.1, R23.1, U9.11, U9.12
unnamed: R39.2, U14.4 (A)
unnamed: R40.2, U13.1 (Y1), U13.5 (Z0)
unnamed: R41.2, R42.2, U13.2 (Y0), U13.3 (Z1)
unnamed: R45.2, R46.2, RV1.2
unnamed: R51.1, U9.6, U9.9
unnamed: R52.1, U17.7 (~Q7)
unnamed: TP1.1, U6.20 (IO1_20/GCLK1)
unnamed: TP2.1, U6.21 (IO1_21)
unnamed: TP3.1, U6.93 (IO3_93)
unnamed: TP4.1, U6.97 (IO3_97)
unnamed: U13.4 (Z), U14.3 (B)
unnamed: U13.15 (Y), U14.38 (C)
PS2_CLK: Q14.1 (S), U6.4 (IO1_4)
PS2_DAT: Q13.1 (S), U6.5 (IO1_5)
RA14: U6.30 (IO1_30), U8.29 (A14)
RA15: U6.29 (IO1_29), U8.3 (A15)
RA16: U6.28 (IO1_28), U8.2 (A16)
RA17: R14.1, U6.27 (IO1_27)
Red0: J8.4, R12.1, U6.142 (IO2_142)
Red1: J8.3, R10.1, U6.1 (IO1_1)
SD_CD: J16.9 (DET_B), J21.9 (DET_B), U6.6 (IO1_6)
SD_CS: J16.2 (DAT3/CD), J21.2 (DAT3/CD), U6.12 (IO1_12)
SD_DAT1: J16.8 (DAT1), J21.8 (DAT1), RN2.2 (R1)
SD_DAT2: J16.1 (DAT2), J21.1 (DAT2), RN2.3 (R2)
SD_MISO: J16.7 (DAT0), J21.7 (DAT0), U6.7 (IO1_7)
SD_MOSI: J16.3 (CMD), J21.3 (CMD), U6.11 (IO1_11)
SD_SCK: J16.5 (CLK), J21.5 (CLK), U6.8 (IO1_8)
SHIFT_CLK: U6.98 (IO3_98), U17.2 (CP)
SHIFT_OUT: R52.2, R53.2, U6.120 (IO2_120)
SHIFT_PL: U6.103 (IO3_103), U17.1 (~PL)
SND_DAC_L: R38.2, U6.81 (IO3_81)
SND_DAC_R: R37.2, U6.88 (IO3_88)
SND_L: C44.2, J9.8, J12.T
SND_MONO: C48.2, J9.6, J15.R1, LS1.1
SND_R: C45.2, J9.9, J12.R1
TAPE_IN: J15.T, J20.5, R47.1
TAPE_IN0: U9.4, U17.14 (D3)
TCK: J11.1, U6.35 (TCK)
TDI: J11.9, U6.34 (TDI)
TDO: J11.3, U6.36 (TDO)
TMS: J11.5, U6.33 (TMS)
VA0: U6.134 (IO2_134), U12.12 (A0)
VA1: U6.133 (IO2_133), U12.11 (A1)
VA2: U6.132 (IO2_132), U12.10 (A2)
VA3: U6.131 (IO2_131), U12.9 (A3)
VA4: U6.130 (IO2_130), U12.8 (A4)
VA5: U6.129 (IO2_129), U12.7 (A5)
VA6: U6.127 (IO2_127), U12.6 (A6)
VA7: U6.125 (IO2_125), U12.5 (A7)
VA8: U6.112 (IO2_112), U12.27 (A8)
VA9: U6.111 (IO2_111), U12.26 (A9)
VA10: U6.106 (IO3_106), U12.23 (A10)
VA11: U6.110 (IO2_110), U12.25 (A11)
VA12: U6.124 (IO2_124), U12.4 (A12)
VA13: U6.113 (IO2_113), U12.28 (A13)
VA14: U6.123 (IO2_123), U12.3 (A14)
VA15: U6.118 (IO2_118), U12.31 (A15)
VA16: U6.122 (IO2_122), U12.2 (A16)
VA17: U6.119 (IO2_119), U12.1 (A18)
VA18: U6.117 (IO2_117), U12.30 (A17)
VD0: U6.137 (IO2_137), U12.13 (D0)
VD1: U6.139 (IO2_139), U12.14 (D1)
VD2: U6.138 (IO2_138), U12.15 (D2)
VD3: U6.101 (IO3_101), U12.17 (D3)
VD4: U6.102 (IO3_102), U12.18 (D4)
VD5: U6.104 (IO3_104), U12.19 (D5)
VD6: U6.108 (IO3_108), U12.20 (D6)
VD7: U6.107 (IO3_107), U12.21 (D7)
VID_B: J9.1, R29.1
VID_COMP: J6.3, J10.1 (In), R31.1
VID_DIN: J6.2, J9.4
VID_G: J9.3, R21.1
VID_MIC: J6.4, J12.S
VID_R: J9.7, R16.2
VID_SYNC: J6.1, J9.5, R9.2
Vsync: J8.6, U6.2 (IO1_2)
xA0: U6.62 (IO4_62), U7.2 (A0)
xA1: U6.61 (IO4_61/DEV_CLRn), U7.3 (A1)
xA2: U6.60 (IO4_60/DEV_OE), U7.4 (A2)
xA3: U6.59 (IO4_59), U7.5 (A3)
xA4: U6.58 (IO4_58), U7.6 (A4)
xA5: U6.66 (IO4_66), U10.8 (A6)
xA6: U6.57 (IO4_57), U7.7 (A5)
xA7: U6.55 (IO4_55), U7.8 (A6)
xA8: U5.7 (A5), U6.45 (IO4_45)
xA9: U5.8 (A6), U6.44 (IO4_44)
xA10: U3.2 (A0), U6.42 (IO4_42)
xA11: U5.9 (A7), U6.43 (IO4_43)
xA12: U6.53 (IO4_53), U7.9 (A7)
xA13: U6.71 (IO4_71), U10.3 (A1)
xA14: U3.8 (A6), U6.32 (IO1_32)
xA15: U3.7 (A5), U6.37 (IO4_37)
xCLKCPU: U6.70 (IO4_70), U10.4 (A2)
xD0: U6.67 (IO4_67), U10.7 (A5)
xD1: U6.68 (IO4_68), U10.6 (A4)
xD2: U6.69 (IO4_69), U10.5 (A3)
xD3: U3.6 (A4), U6.38 (IO4_38)
xD4: U3.9 (A7), U6.31 (IO1_31)
xD5: U3.5 (A3), U6.39 (IO4_39)
xD6: U3.4 (A2), U6.40 (IO4_40)
xD7: U3.3 (A1), U6.41 (IO4_41)
~BUSACK: J2.A26 (Pin_a26), J18.3, U4.23 (~BUSACK)
~BUSRQ: J2.A19 (Pin_a19), J18.5, R32.1, U4.25 (~BUSRQ)
~CLKCPU: J2.A8 (Pin_a8), R48.1, U10.18 (B0)
~DRD: J2.A16 (Pin_a16), U6.78 (IO3_78)
~DWR: J2.A17 (Pin_a17), U6.77 (IO3_77)
~HALT: J2.B15 (Pin_b15), J18.4, U4.18 (~HALT)
~INTB: J2.B13 (Pin_b13), R49.1, U4.16 (~INT)
~INT: J18.40, R49.2, U6.73 (IO3_73)
~IORQGE: J2.A13 (Pin_a13), J18.19, R4.1, U10.11 (B7)
~IORQ: J2.B17 (Pin_b17), J18.13, R4.2, U4.20 (~IORQ)
~JOY_B1: J7.6, RN3.7 (R6), U17.3 (D4)
~JOY_B2: J7.9, RN3.2 (R1), U17.11 (D0)
~JOY_DOWN: J7.2, RN3.6 (R5), U17.4 (D5)
~JOY_LEFT: J7.3, RN3.4 (R3), U17.5 (D6)
~JOY_RIGHT: J7.4, RN3.3 (R2), U17.6 (D7)
~JOY_UP: J7.1, RN3.8 (R7), U17.13 (D2)
~M1: J2.B24 (Pin_b24), J18.25, U4.27 (~M1), U5.14 (B4)
~MAGIC: J14.1, SW2.2, U6.84 (IO3_84)
~MREQ: J2.B16 (Pin_b16), J18.27, U4.19 (~MREQ), U5.18 (B0)
~MTR: J2.A18 (Pin_a18), U6.76 (IO3_76)
~NMI: J2.B14 (Pin_b14), J18.41, U4.17 (~NMI), U6.74 (IO3_74)
~RD: J2.B18 (Pin_b18), J18.17, U4.21 (~RD), U5.15 (B3), U8.24 (~OE)
~RFSH: J2.B25 (Pin_b25), J18.26, U4.28 (~RFSH), U5.17 (B1)
~ROMCSB: J2.A25 (Pin_a25), J18.12, R8.2, U8.22 (~CE)
~ROMCS: R8.1, U6.24 (IO1_24)
~RSTCPU: J2.A20 (Pin_a20), J18.44, U4.26 (~RESET), U6.75 (IO3_75), U14.23 (~RESET)
~RST: C49.1, J17.1, SW3.2, U6.85 (IO3_85)
~VRD: U6.109 (IO2_109), U12.24 (~OE)
~VWR: U6.114 (IO2_114), U12.29 (~WE)
~WAIT: J2.B21 (Pin_b21), J18.7, R33.1, U4.24 (~WAIT)
~WR: J2.B19 (Pin_b19), J18.15, JP4.1, U4.22 (~WR), U5.16 (B2)
~xCLKCPU: U6.72 (IO4_72), U10.2 (A0)
~xIORQGE: U6.63 (IO4_63), U10.9 (A7)
~xM1: U5.6 (A4), U6.48 (IO4_48)
~xMREQ: U5.2 (A0), U6.52 (IO4_52)
~xRD: U5.5 (A3), U6.49 (IO4_49)
~xRFSH: U5.3 (A1), U6.51 (IO4_51)
~xWR: U5.4 (A2), U6.50 (IO4_50)

Notes on the sheet:
AY Serial: IO2 - RTS (out) IO3 - TX (out) IO6 - DTR (in) IO7 - RX (in)
For 256K RAM compatibility: VA18<->A17 VA17<->A18
JOYSTICK
MEMORY
HCU only!
2N7000 may be used with some cautions due to high Vgs(th)
For LM2596-5.0: R1 - 0 Ohm R2,C1 - do not install
NTSC
jumper on 2-3 for composite cables jumper on 1-2 for chinese rgb cables
VIDEO
POWER
install one of J9 or J10
1-bit DAC
PS/2
install one of L1 or L2
PORTS
x1 x0 Vout(mV) --------- 0 0 0 0 1 0 z 1 133 1 0 437 1 z 568 1 1 682
CPLD
If ZXKIT1 setting enabled in menu: - Hsync acts as Csync - Vsync acts as 14MHz out
install one of J16 or J21
CPU
DAT* pullups connected to keyboard's RN
ZXBUS
0 - ACB 1 - ABC
SD CARD
KEYBOARD
JTAG
PAL
BUTTONS
SOUND
connect to VCC for DIP28
TAPE
MH-M18 Bluetooth module header
CLOCK
